Joshua162005/gas_guard/(commit log)

2026-11-07 chore: fix the issues
    [gas_detector.h]
2026-11-07 fix: tab icon fixes implemented
    [gas_detector.h]
2026-11-07 feat: add arduino
2026-11-07 chore: fix buzzer tone
    [arduino_uno_sensor.ino, esp32_gateway.ino, gas_detector.h, uno_frame.h]
